amclain/roc-200/schematics/README.md

# Schematics

Schematics are created with [Autodesk Eagle](https://www.autodesk.com/products/eagle/free-download),
which has a free download option available.

These schematics use the following add-on libraries:
* [amclain/eagle-libraries](https://github.com/amclain/eagle-libraries)
