amclain/roc-200/design/images/internal.jpg

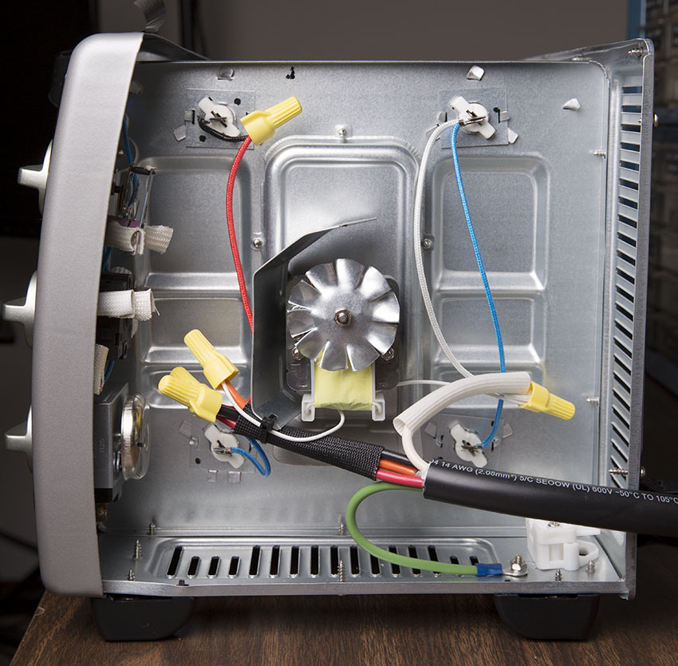
design/images/internal.jpg
