amclain/roc-200/design/reflow_oven.png

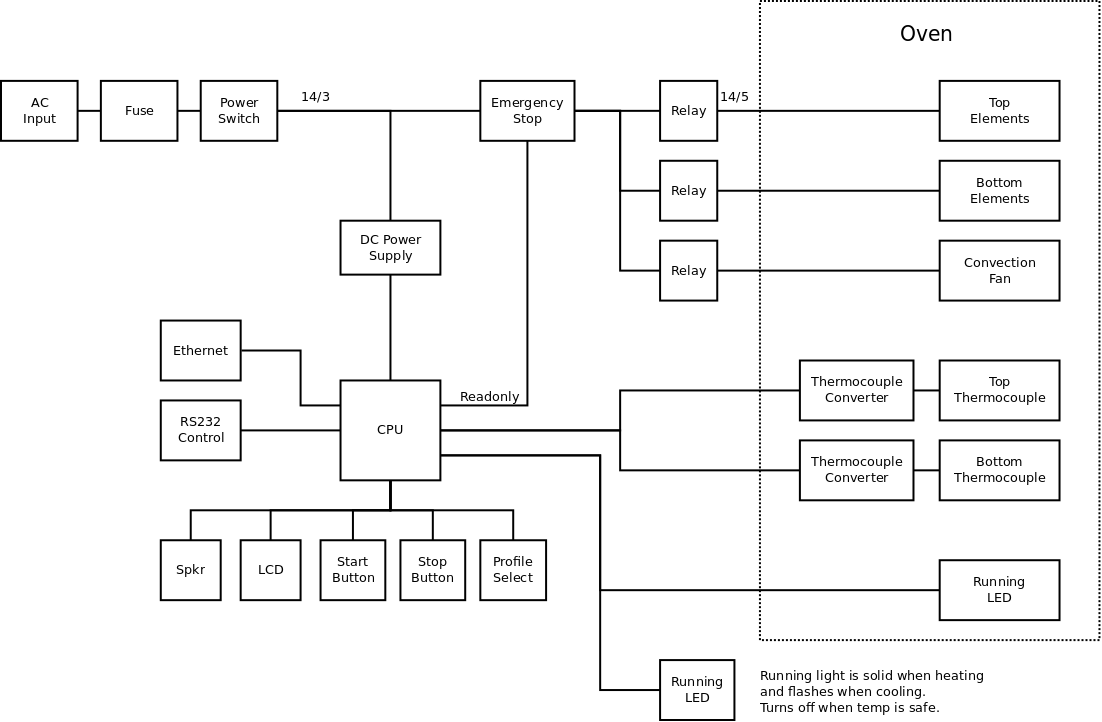
design/reflow_oven.png
