amclain/roc-200/schematics/controller_main_board.pdf

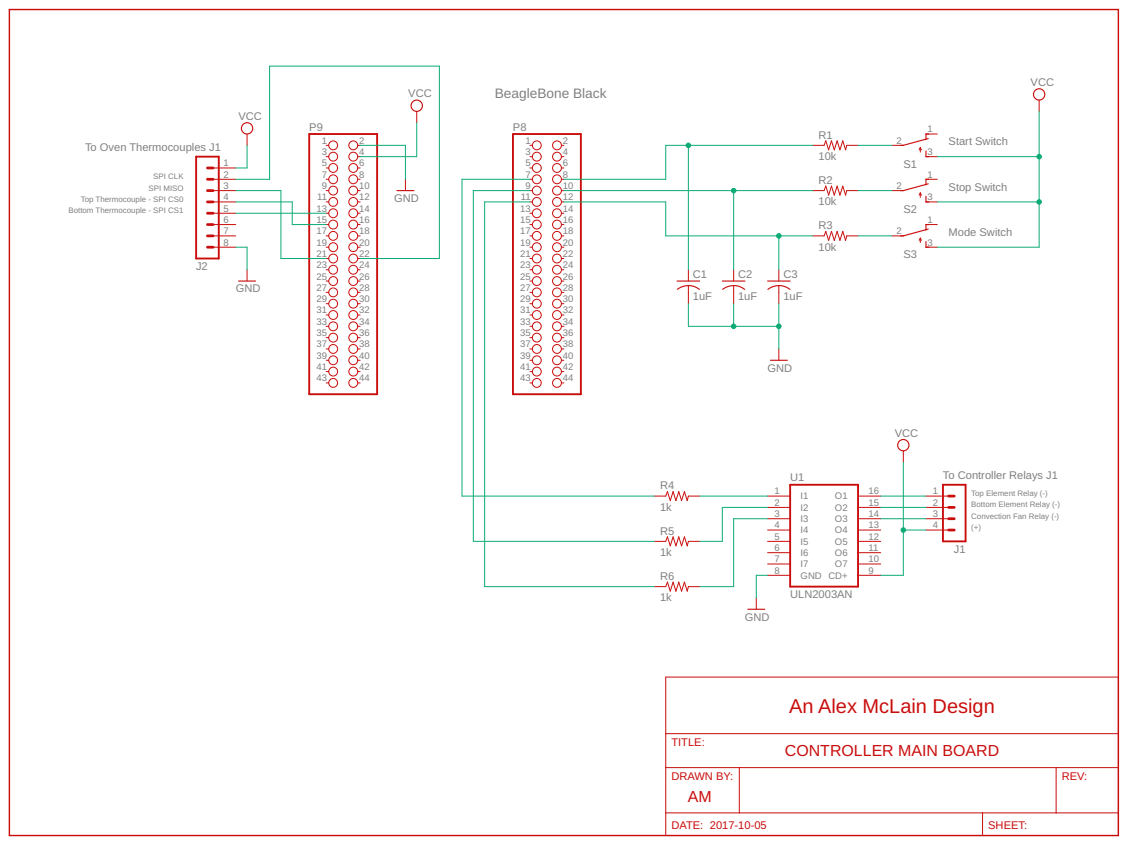
[picture p6: page 1]

Top Thermocouple - SPI CS0 Bottom Thermocouple - SPI CS1

Top Element Relay (-) Bottom Element Relay (-) Convection Fan Relay (-)

An Alex McLain Design
