amclain/roc-200/schematics/controller_relays.pdf

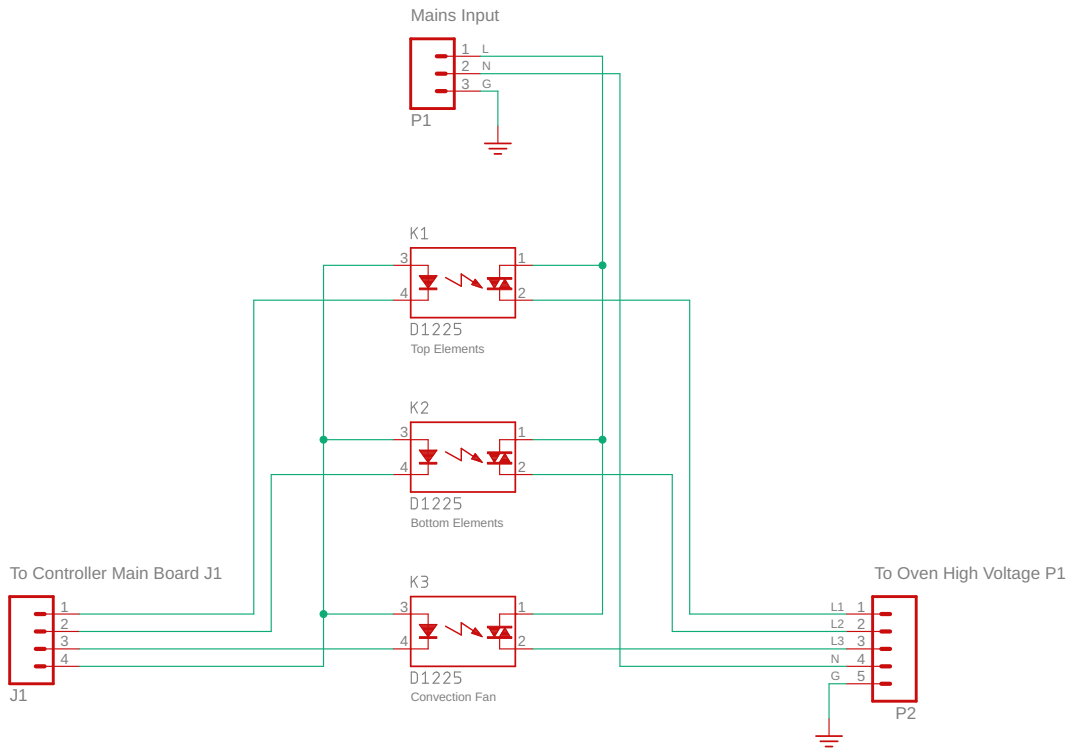
[picture p7: page 1]

To Controller Main Board J1

To Oven High Voltage P1

An Alex McLain Design
