amclain/roc-200/schematics/oven_thermocouples.pdf

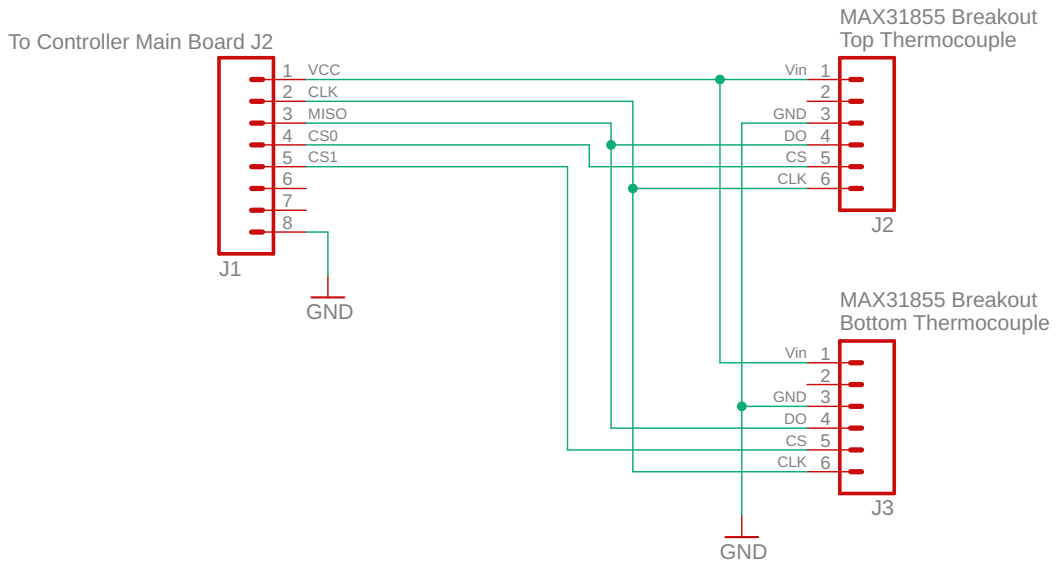
[picture p8: page 1]

To Controller Main Board J2

An Alex McLain Design
