amclain/roc-200/schematics/oven_high_voltage.pdf

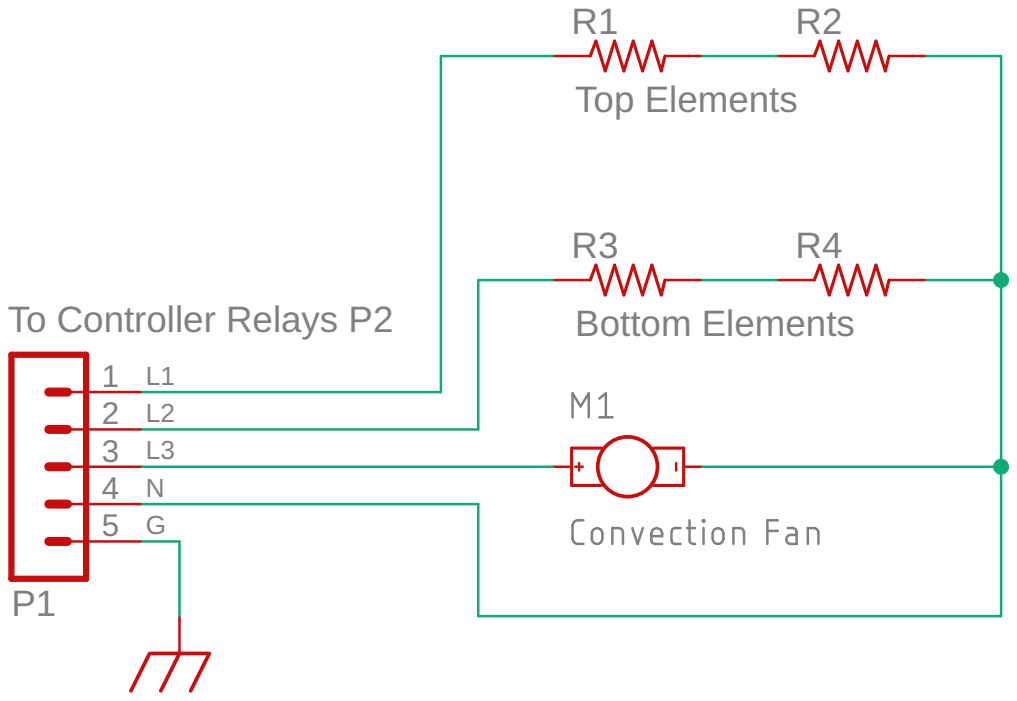
[picture p9: page 1]

An Alex McLain Design
