amclain/roc-200/schematics/controller_main_board.sch

## EAGLE design schematics/controller_main_board.sch (2017-10-08)

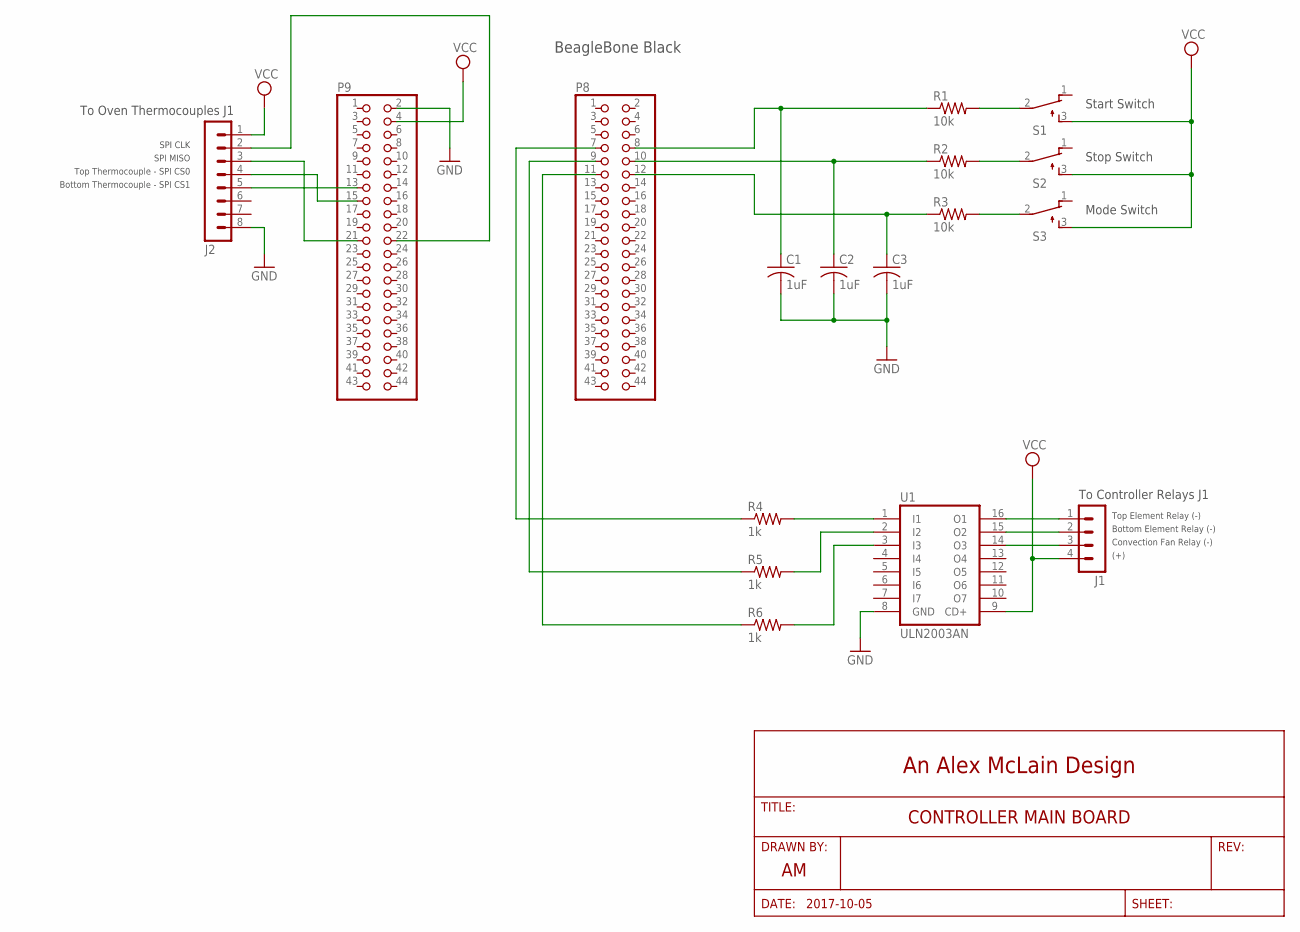
[picture p10: schematic controller_main_board.sch]

Parts:
C1, C2, C3: 1uF; C025-050X050
J1: MA04-1
J2: MA08-1
P8, P9: PINHD-2X22; 2X22
R1, R2, R3: 10k; 0204/7
R4, R5, R6: 1k; 0204/7
S1, S2, S3: TL32PO; TL3XPO
U1: ULN2003AN; DIL16

Connections:
GND: C1.2, C2.2, C3.2, J2.8, P9.2, U1.8 (GND)
unnamed: C1.1, P8.8, R1.1
unnamed: C2.1, P8.10, R2.1
unnamed: C3.1, P8.12, R3.1
unnamed: P8.11, R6.1
unnamed: P8.9, R5.1
unnamed: P8.7, R4.1
unnamed: R1.2, S1.2
unnamed: R2.2, S2.2
unnamed: R3.2, S3.2
unnamed: R4.2, U1.1 (I1)
unnamed: R5.2, U1.2 (I2)
unnamed: R6.2, U1.3 (I3)
unnamed: J1.1, U1.16 (O1)
unnamed: J1.2, U1.15 (O2)
unnamed: J1.3, U1.14 (O3)
unnamed: J2.5, P9.13
unnamed: J2.4, P9.15
unnamed: J2.3, P9.21
unnamed: J2.2, P9.22
VCC: J1.4, J2.1, P9.4, S1.3 (S), S2.3 (S), S3.3 (S), U1.9 (CD+)

Notes on the sheet:
Top Element Relay (-)
Bottom Element Relay (-)
Convection Fan Relay (-)
Start Switch
Stop Switch
Mode Switch
SPI CLK
SPI MISO
Top Thermocouple - SPI CS0
Bottom Thermocouple - SPI CS1
BeagleBone Black
(+)
To Controller Relays J1
To Oven Thermocouples J1
