amclain/roc-200/schematics/controller_relays.sch

## EAGLE design schematics/controller_relays.sch (2017-10-08)

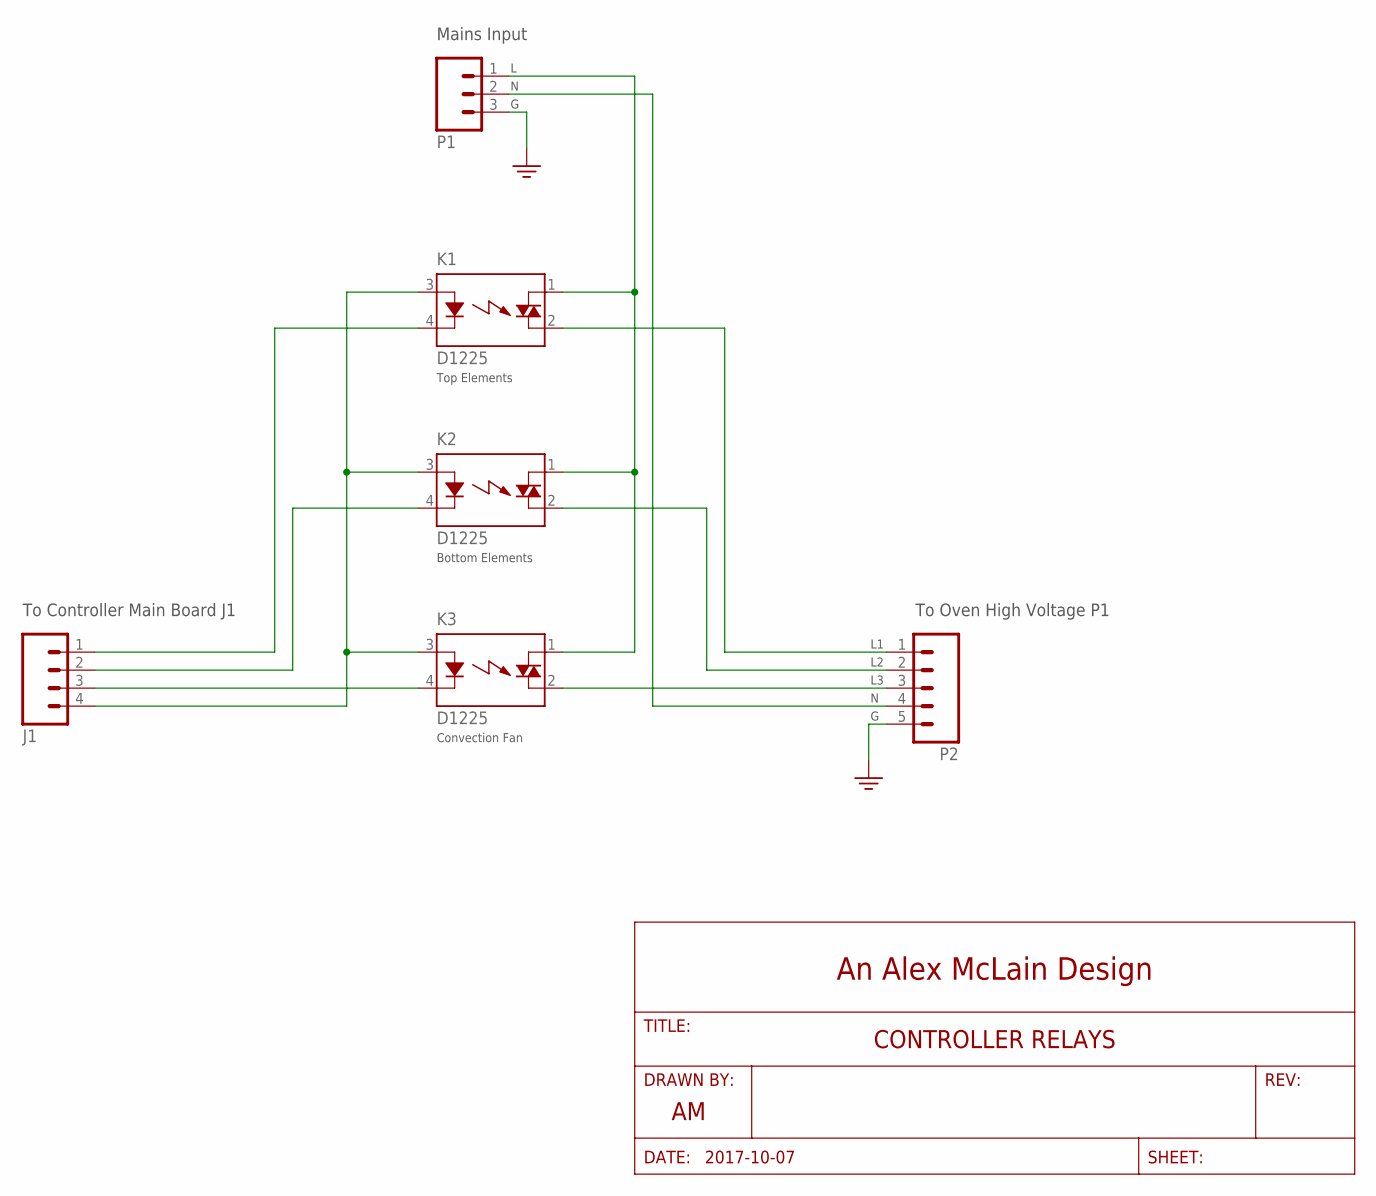
[picture p11: schematic controller_relays.sch]

Parts:
J1: MA04; 04PA
K1, K2, K3: D1225; AQ1-FLAT
P1: MA03; 03P
P2: MA05; 05PA

Connections:
GND: P1.3, P2.5
unnamed: J1.4, K1.3 (A), K2.3 (A), K3.3 (A)
unnamed: J1.3, K3.4 (K)
unnamed: J1.2, K2.4 (K)
unnamed: J1.1, K1.4 (K)
unnamed: K1.1 (DS1), K2.1 (DS1), K3.1 (DS1), P1.1
unnamed: K1.2 (DS2), P2.1
unnamed: K2.2 (DS2), P2.2
unnamed: K3.2 (DS2), P2.3
unnamed: P1.2, P2.4

Notes on the sheet:
To Controller Main Board J1
Mains Input
To Oven High Voltage P1
Top Elements
Bottom Elements
Convection Fan
