amclain/roc-200/schematics/oven_high_voltage.sch

## EAGLE design schematics/oven_high_voltage.sch (2017-10-08)

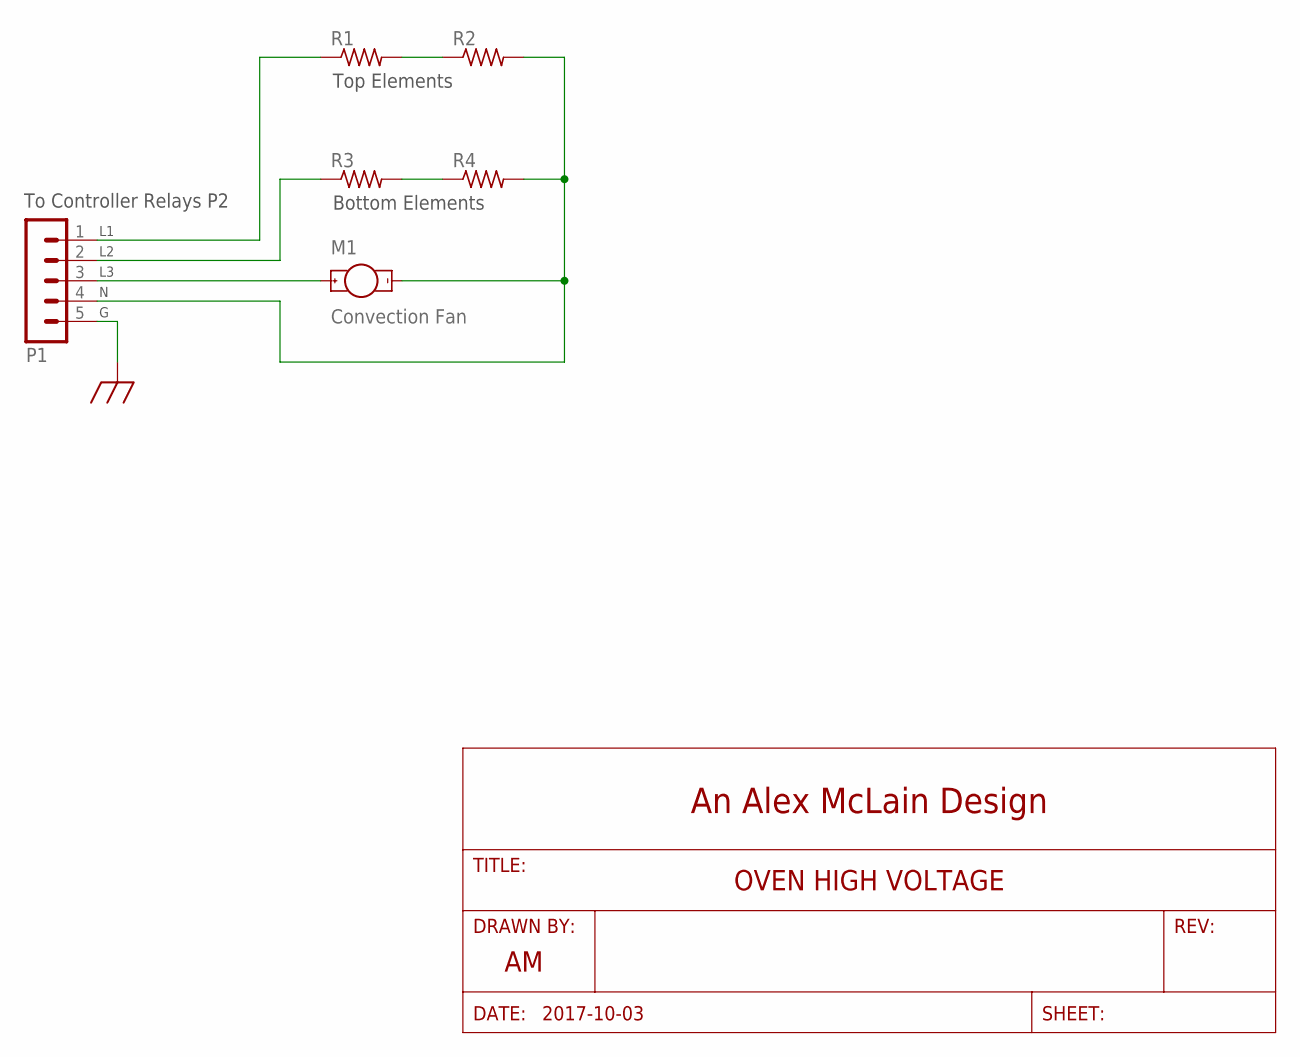
[picture p12: schematic oven_high_voltage.sch]

Parts:
M1: Convection Fan; VIBE-MOTOR-10MM
P1: MA05-1
R1, R2, R3, R4: R-US_0204/7; 0204/7

Connections:
GND: P1.5
unnamed: M1.+, P1.3
unnamed: R1.2, R2.1
unnamed: R3.2, R4.1
unnamed: P1.2, R3.1
unnamed: P1.1, R1.1
unnamed: M1.-, P1.4, R2.2, R4.2

Notes on the sheet:
Top Elements
To Controller Relays P2
Bottom Elements
