amclain/roc-200/schematics/oven_thermocouples.sch

## EAGLE design schematics/oven_thermocouples.sch (2017-10-08)

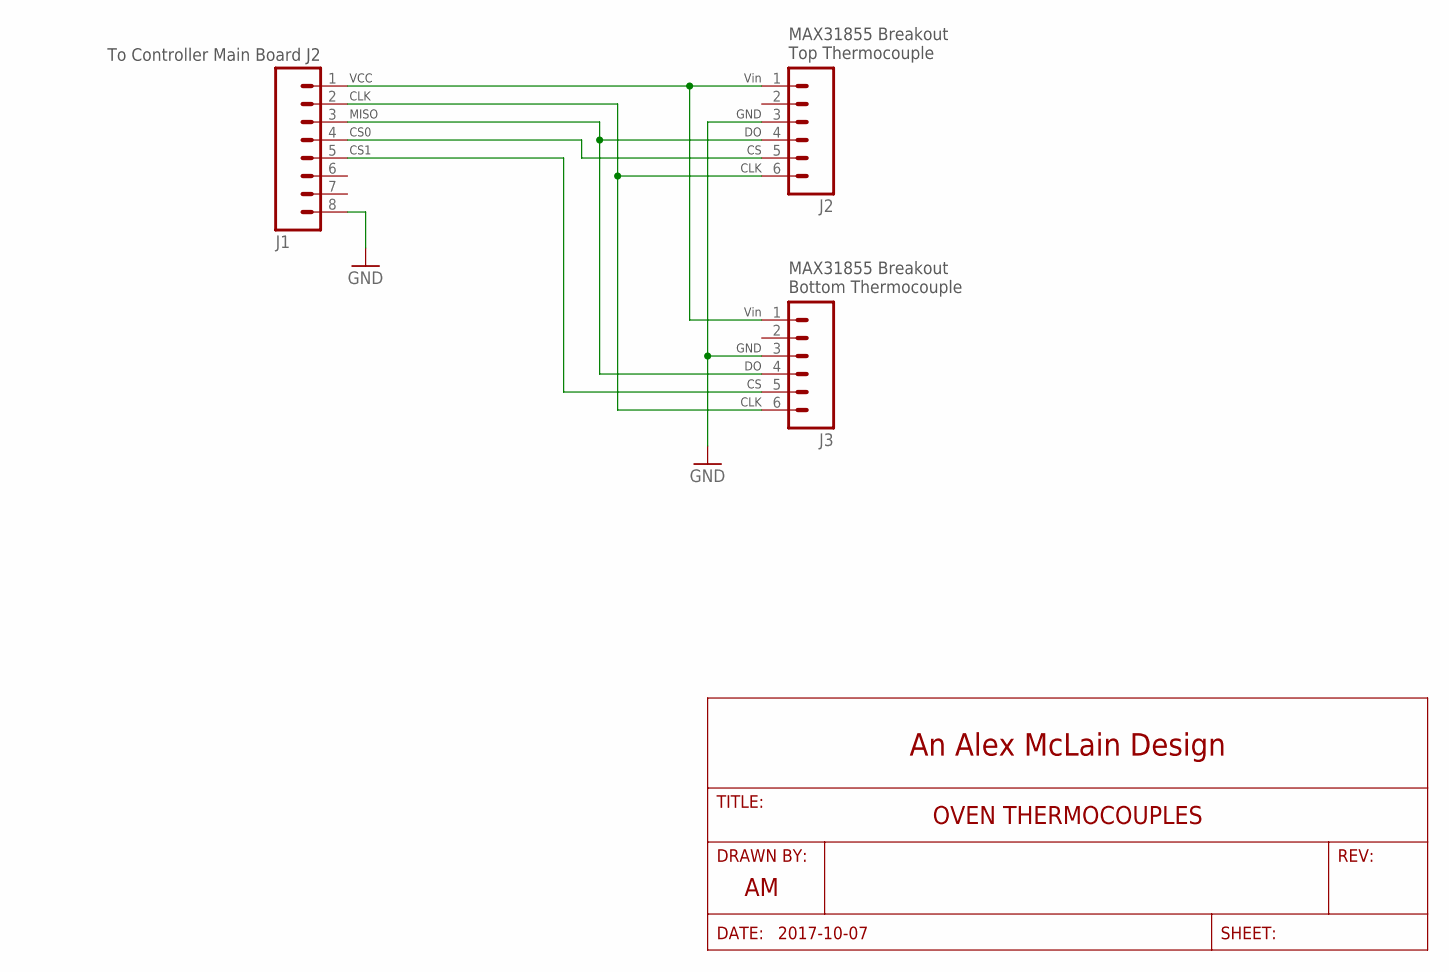
[picture p13: schematic oven_thermocouples.sch]

Parts:
J1: MA08; 08PA
J2, J3: MA06; 06PA

Connections:
GND: J1.8, J2.3, J3.3
unnamed: J1.2, J2.6, J3.6
unnamed: J1.3, J2.4, J3.4
unnamed: J1.4, J2.5
unnamed: J1.5, J3.5
unnamed: J1.1, J2.1, J3.1

Notes on the sheet:
To Controller Main Board J2
MAX31855 Breakout Top Thermocouple
MAX31855 Breakout Bottom Thermocouple
CLK
MISO
CS0
CS1
Vin
GND
VCC
