amclain/roc-200/(commit log)

2017-09-22 Implement button input.
2017-09-23 Implement oven relay control.
2017-09-25 Add SPI interface.
2017-10-01 Add preliminary BOM.
    [BOM.csv]
2017-10-04 Add oven high voltage schematic.
    [oven_high_voltage.sch]
2017-10-06 Add controller main board schematic.
    [controller_main_board.sch]
2017-10-08 Move labels to info layer.
    [oven_high_voltage.sch]
2017-10-08 Add custom title block.
    [controller_main_board.sch, oven_high_voltage.sch]
2017-10-08 Add controller relays schematic.
    [controller_main_board.sch, controller_relays.sch, oven_high_voltage.sch]
2017-10-08 Add oven thermocouples schematic.
    [controller_main_board.sch, oven_thermocouples.sch]
2017-10-08 Update title block template.
    [controller_main_board.sch, controller_relays.sch, oven_high_voltage.sch, oven_thermocouples.sch]
2017-10-08 Update earth and chassis ground symbols.
    [controller_relays.sch, oven_high_voltage.sch]
2017-10-08 Add THHN wire and lugs to BOM.
    [BOM.csv]
2018-11-04 Export design and schematics to common file formats.
